patrickkolbaycertus/ProbeCardKiCAD/Probe Card Driver/Probe Card Driver.pdf

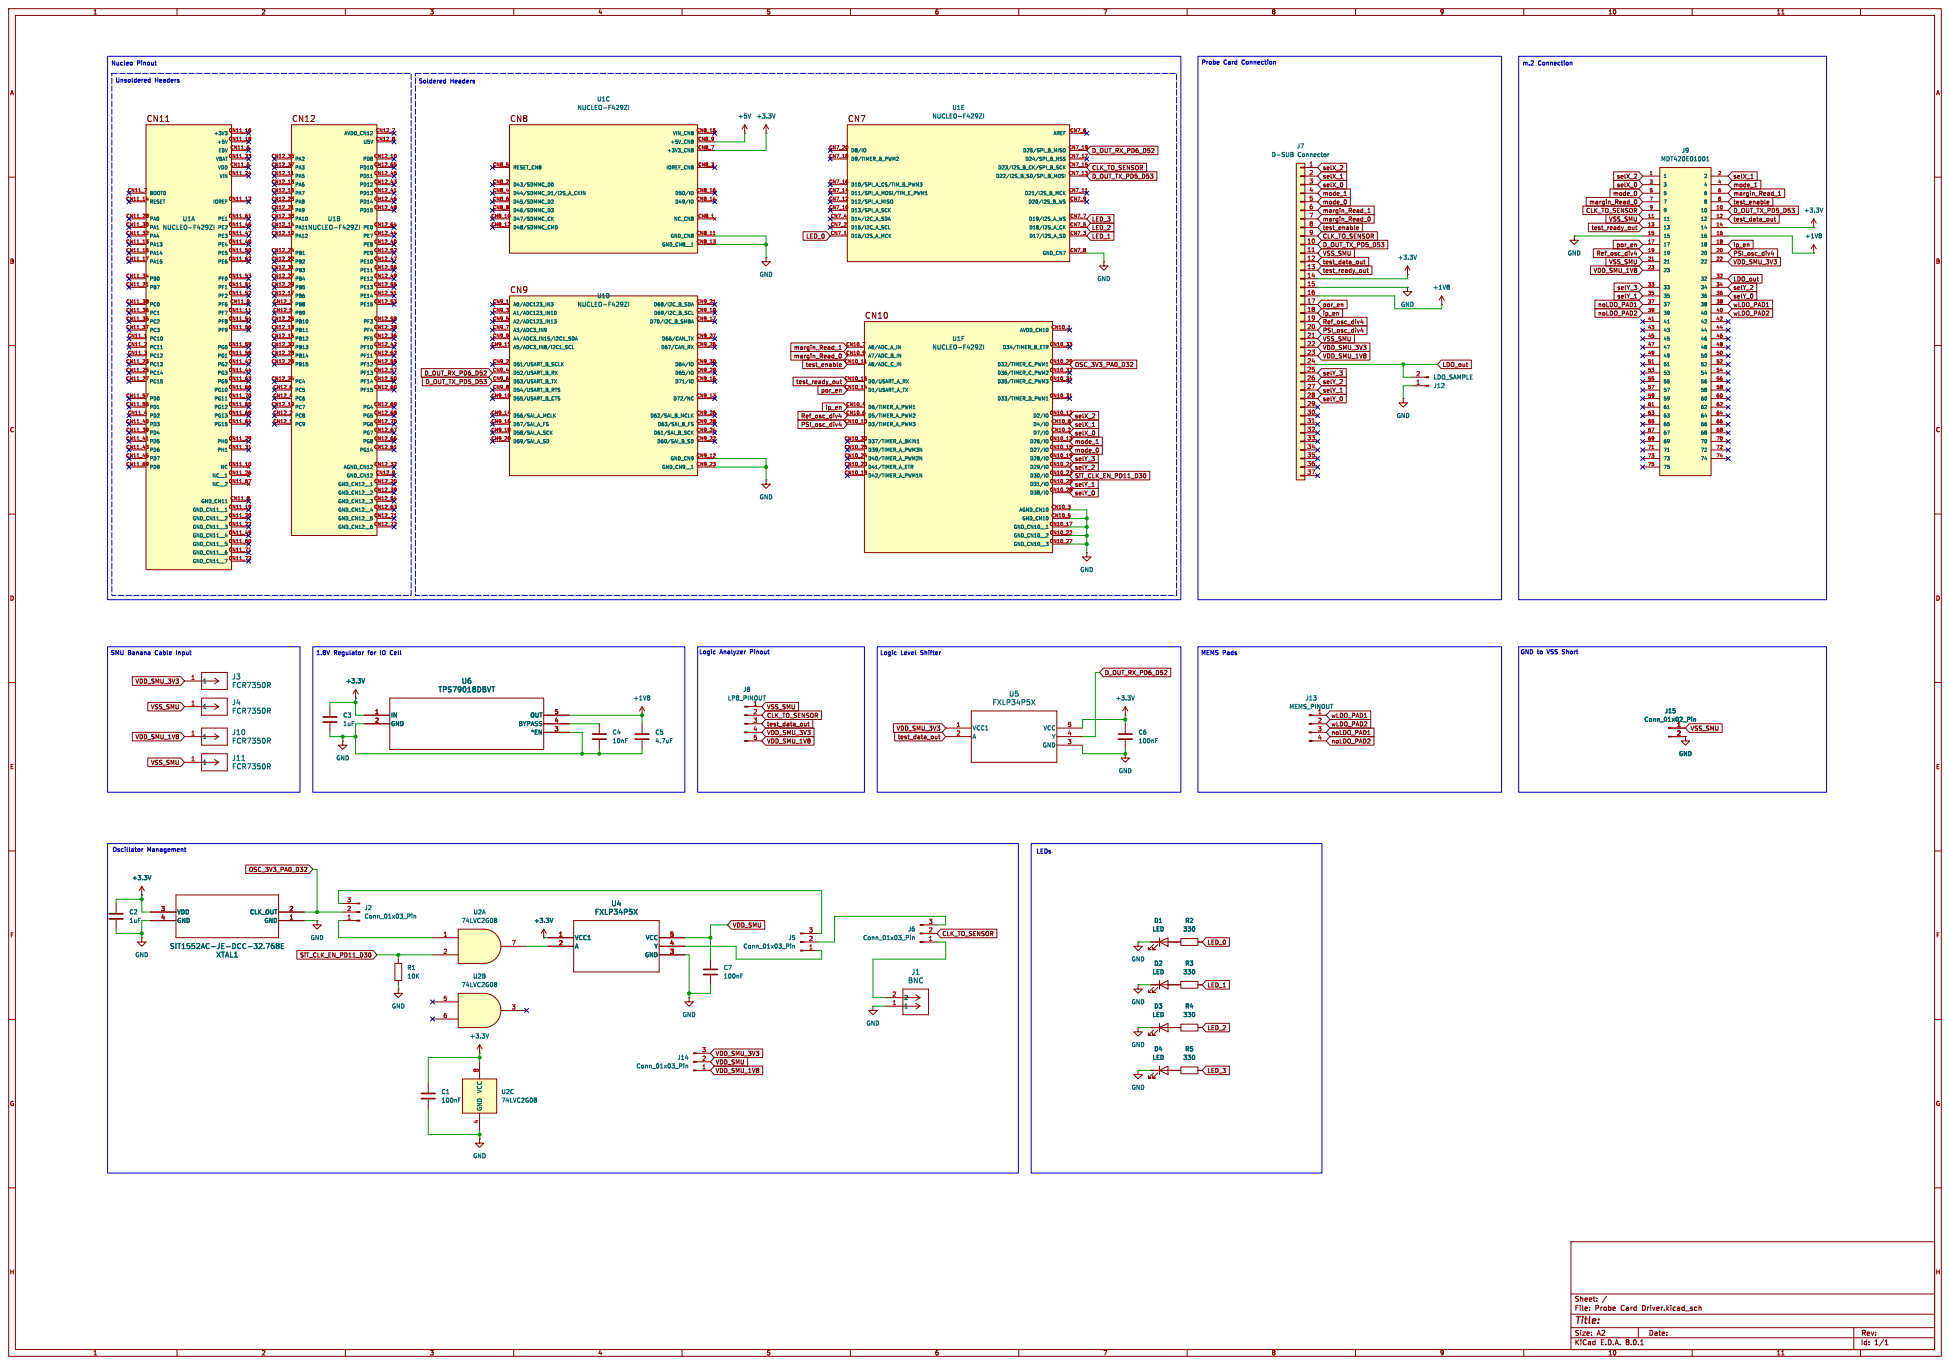
[picture p1: page 1]
