patrickkolbaycertus/ProbeCardKiCAD/Probe Card Driver/Probe Card Driver.kicad_pcb

## KiCad design Probe Card Driver/Probe Card Driver.kicad_pcb (2024-08-28)

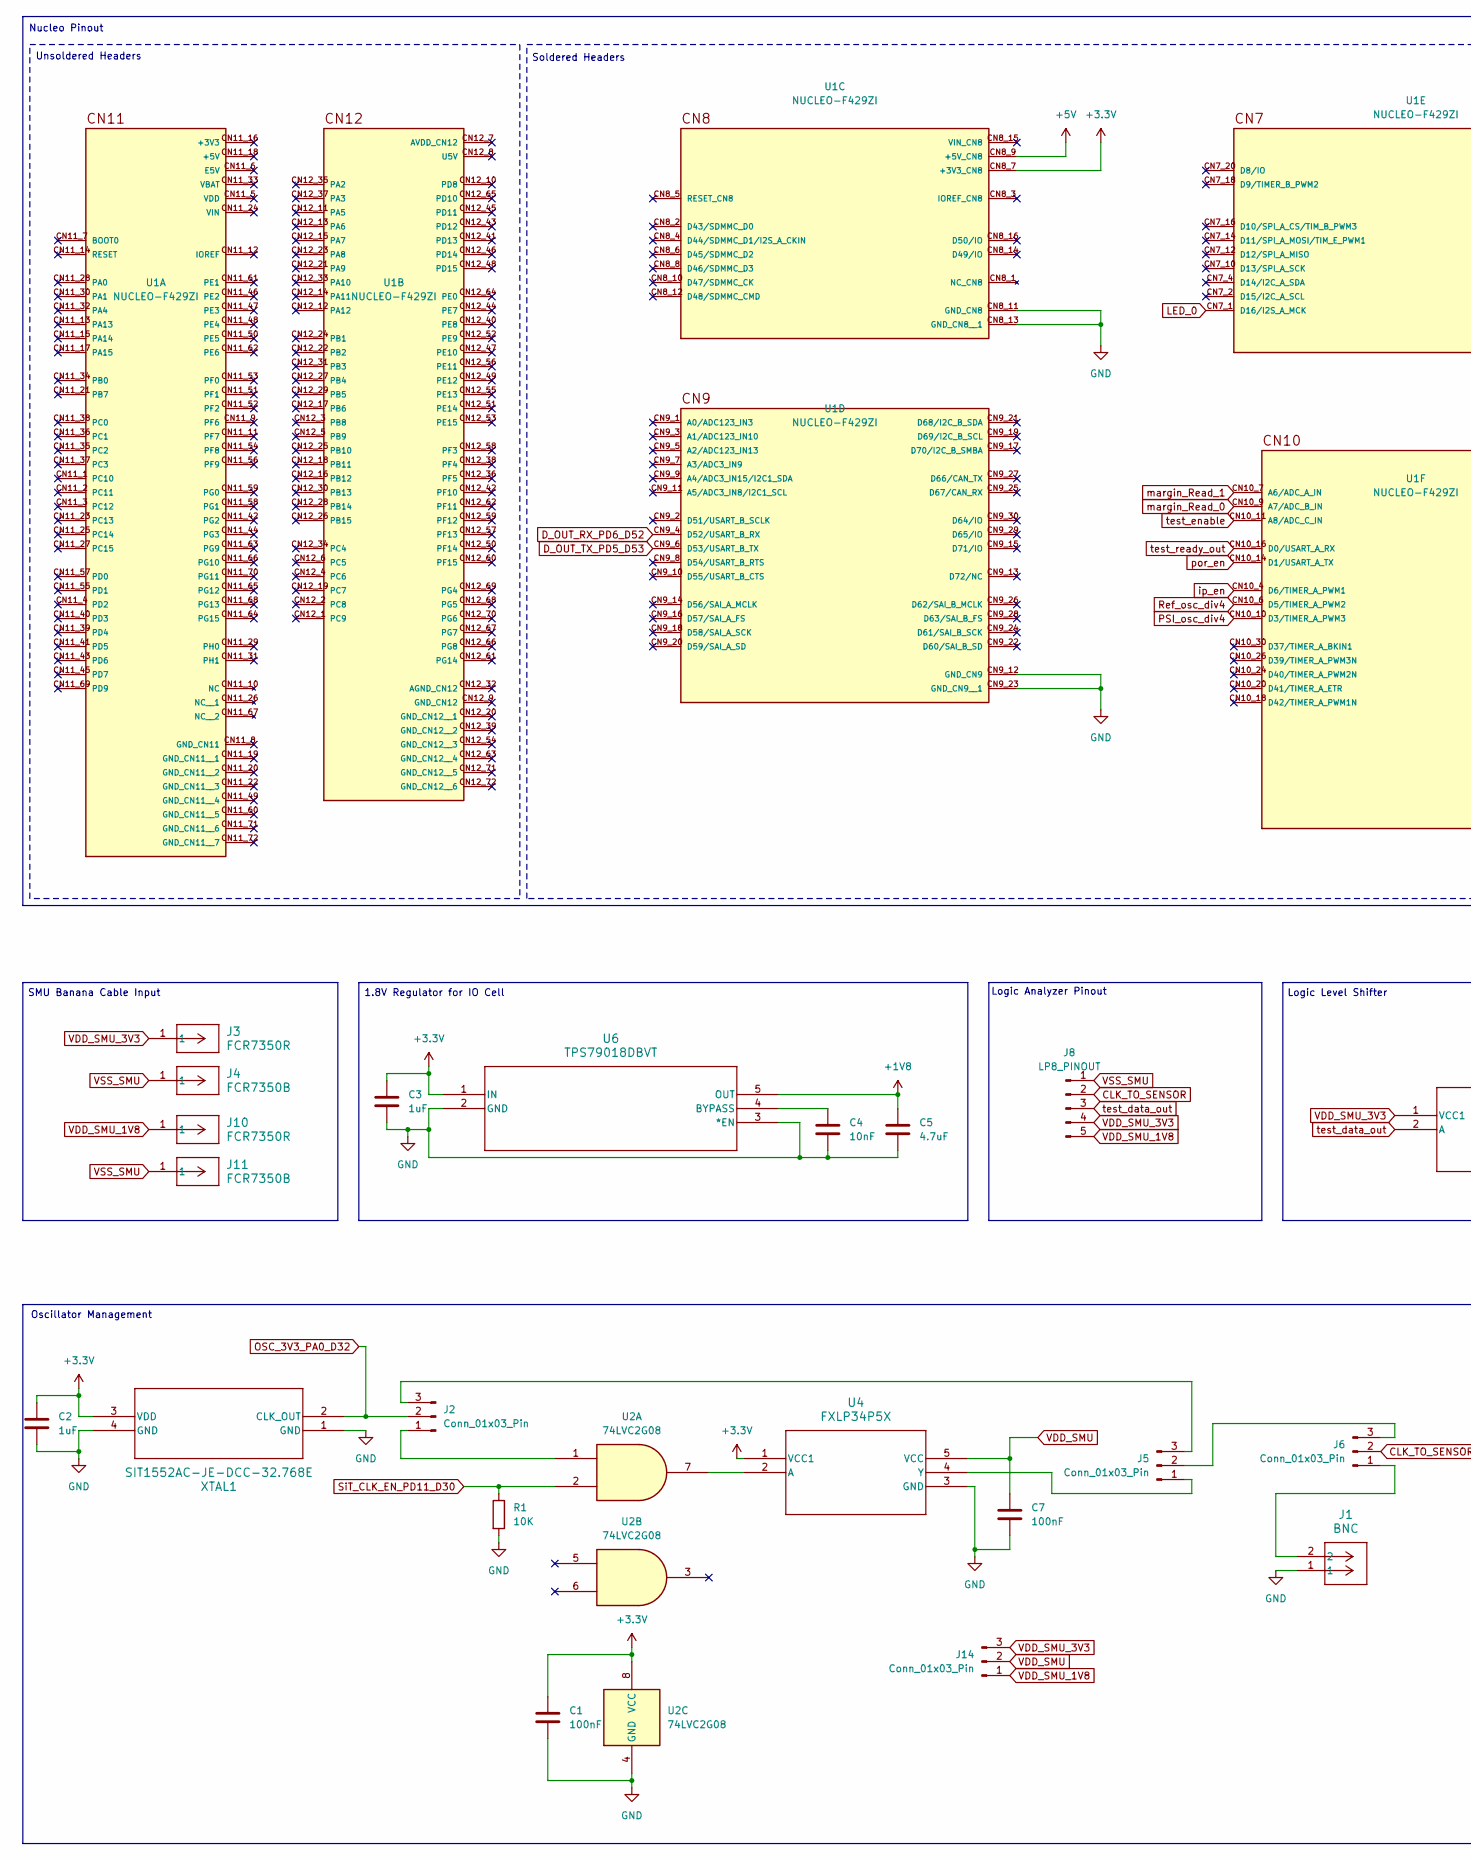
[picture p2: schematic Probe Card Driver.kicad_sch, part in row 1, column 1]

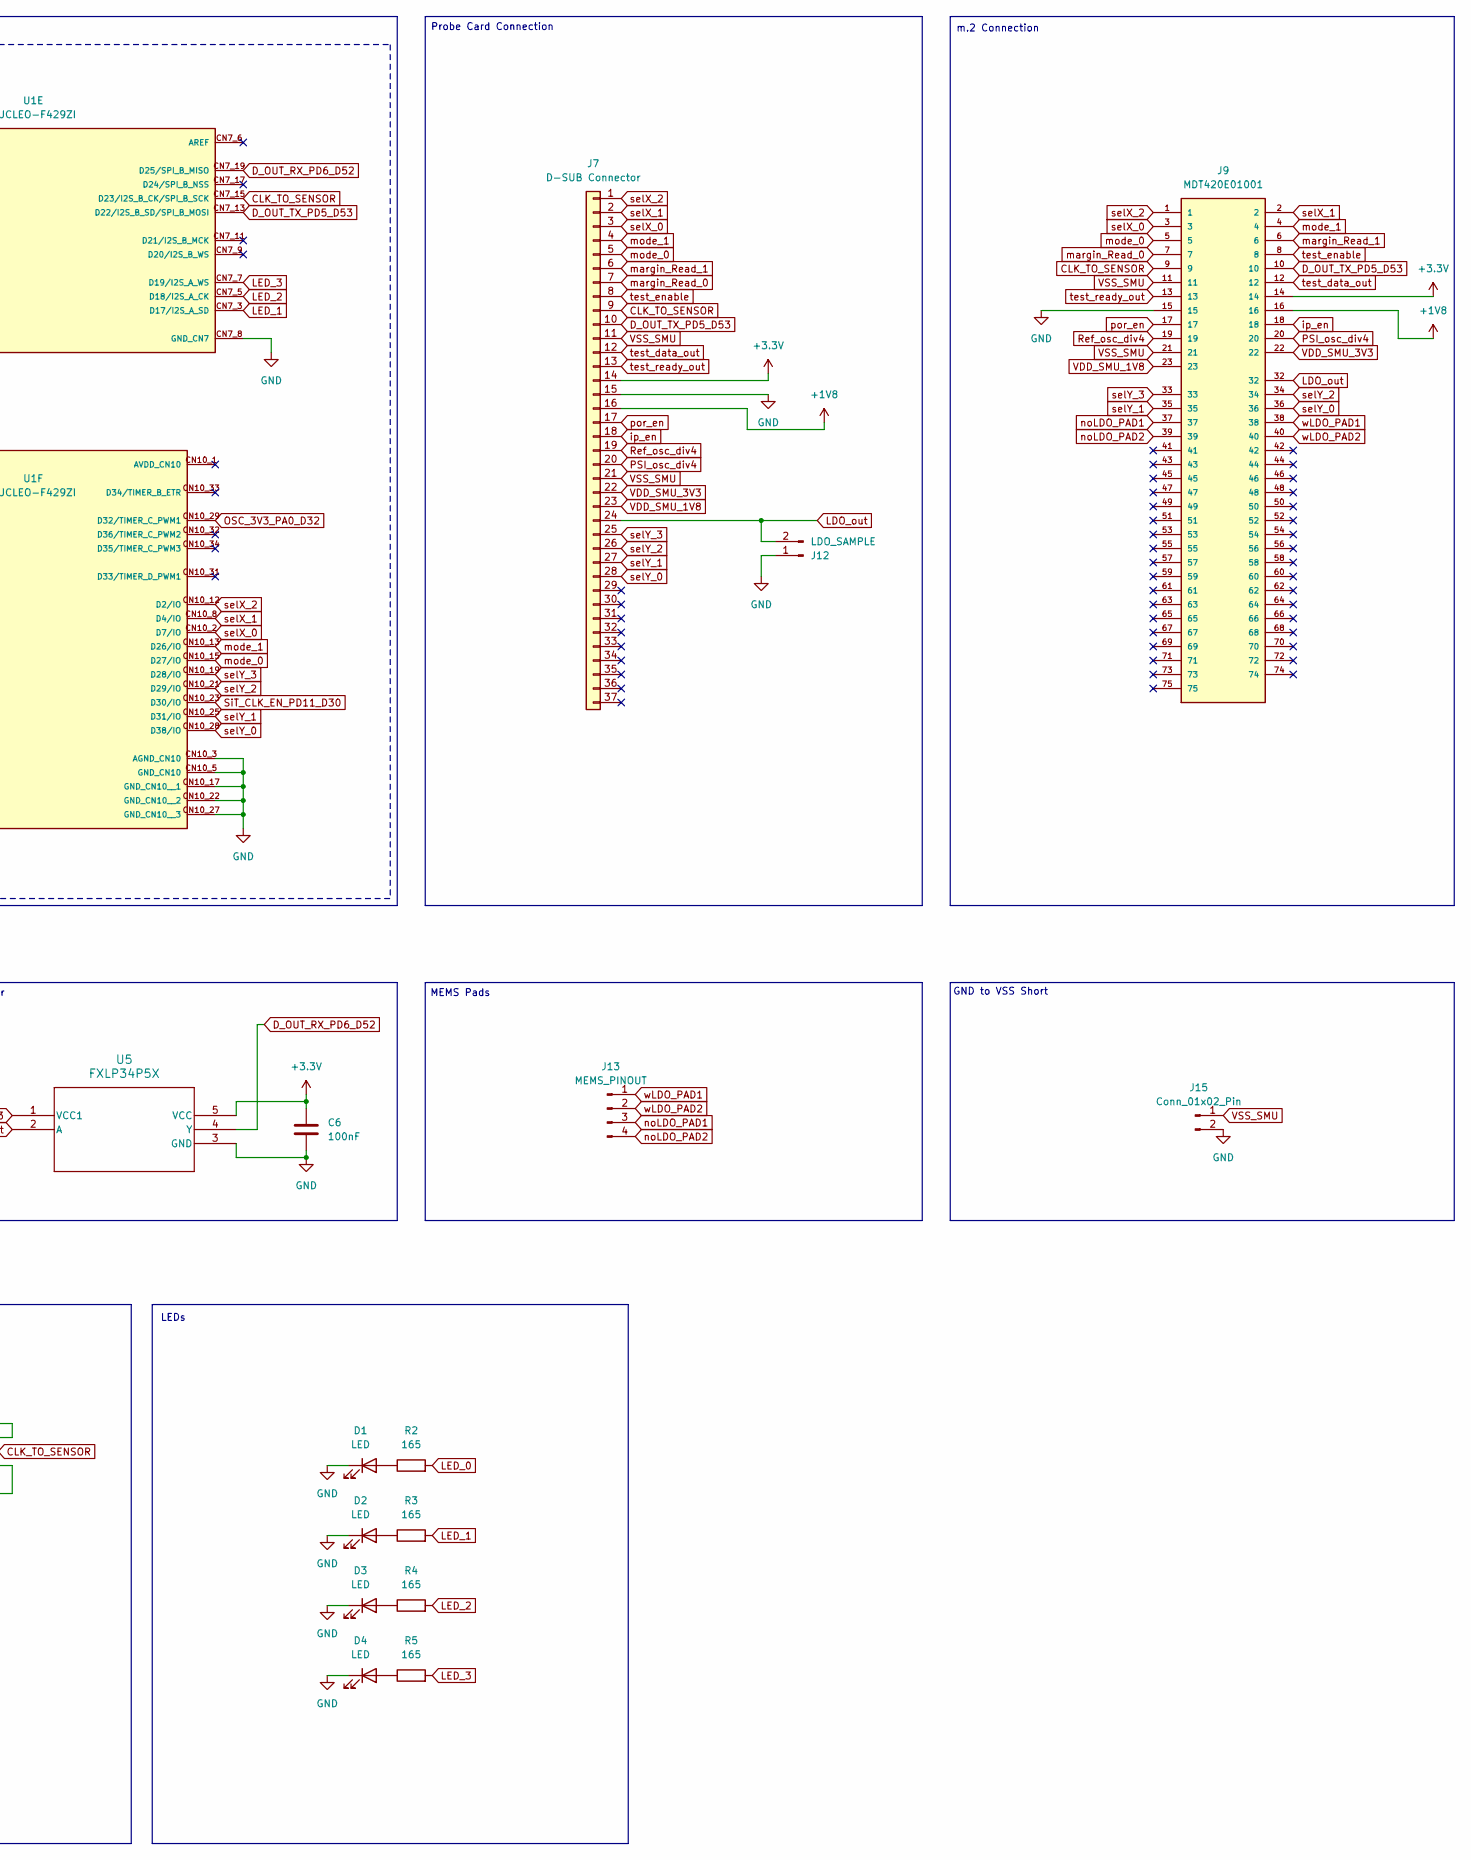
[picture p3: schematic Probe Card Driver.kicad_sch, part in row 1, column 2]

Parts:
C1, C6, C7: 100nF; C_0603_1608Metric
C2, C3: 1uF; C_0603_1608Metric
C4: 10nF; C_0603_1608Metric
C5: 4.7uF; C_0603_1608Metric
D1, D2, D3, D4: LED; LED_0603_1608Metric
J1: BNC; CONN_CONBN_LNX
J2, J5, J6, J14: Conn_01x03_Pin; PinHeader_1x03_P2.54mm_Vertical
J3, J10: FCR7350R; CONN1_FCR7350R_CLF
J4, J11: FCR7350B; CONN1_FCR7350R_CLF
J7: D-SUB Connector; D37P33E4GX00LF
J8: LP8_PINOUT; PinSocket_1x05_P2.54mm_Vertical
J9: MDT420E01001; M.2-CONNECTOR-E; PARTREV 7
J12: LDO_SAMPLE; PinSocket_1x02_P2.54mm_Vertical
J13: MEMS_PINOUT; PinSocket_1x04_P2.54mm_Vertical
J15: Conn_01x02_Pin; PinHeader_1x02_P2.54mm_Vertical
R1: 10K; R_0603_1608Metric
R2, R3, R4, R5: 165; R_0603_1608Metric
U1: NUCLEO-F429ZI; MODULE_NUCLEO-F429ZI; PARTREV 8
U2: 74LVC2G08; DCU8
U4, U5: FXLP34P5X; SC70-5_2P2X1P3_ONS
U6: TPS79018DBVT; DBV5
XTAL1: SIT1552AC-JE-DCC-32.768E; BGA4_SiT1532_SIT

Connections:
+1V8: C5.1, J7.16, J9.16, U6.5 (OUT)
+3.3V: C1.1, C2.1, C3.1, C6.1, J7.14, J9.14, U1.CN8_7 (+3V3_CN8), U2.8 (VCC), U4.1 (VCC1), U5.5 (VCC), U6.1 (IN), XTAL1.3 (VDD)
+5V: U1.CN8_9 (+5V_CN8)
CLK_TO_SENSOR: J6.2, J7.9, J8.2, J9.9, U1.CN7_15 (D23/I2S_B_CK/SPI_B_SCK)
D_OUT_RX_PD6_D52: U1.CN7_19 (D25/SPI_B_MISO), U1.CN9_4 (D52/USART_B_RX), U5.4 (Y)
D_OUT_TX_PD5_D53: J7.10, J9.10, U1.CN7_13 (D22/I2S_B_SD/SPI_B_MOSI), U1.CN9_6 (D53/USART_B_TX)
GND: C1.2, C2.2, C3.2, C4.2, C5.2, C6.2, C7.2, D1.1 (K), D2.1 (K), D3.1 (K), D4.1 (K), J1.1, J7.15, J9.15, J12.1, J15.2, R1.2, U1.CN7_8 (GND_CN7), U1.CN8_11 (GND_CN8), U1.CN8_13 (GND_CN8__1), U1.CN9_12 (GND_CN9), U1.CN9_23 (GND_CN9__1), U1.CN10_3 (AGND_CN10), U1.CN10_5 (GND_CN10), U1.CN10_17 (GND_CN10__1), U1.CN10_22 (GND_CN10__2), U1.CN10_27 (GND_CN10__3), U2.4 (GND), U4.3 (GND), U5.3 (GND), U6.2 (GND), U6.3 (*EN), XTAL1.1 (GND), XTAL1.4 (GND)
LDO_out: J7.24, J9.32, J12.2
LED_0: R2.2, U1.CN7_1 (D16/I2S_A_MCK)
LED_1: R3.2, U1.CN7_3 (D17/I2S_A_SD)
LED_2: R4.2, U1.CN7_5 (D18/I2S_A_CK)
LED_3: R5.2, U1.CN7_7 (D19/I2S_A_WS)
unnamed: D1.2 (A), R2.1
unnamed: D2.2 (A), R3.1
unnamed: D3.2 (A), R4.1
unnamed: D4.2 (A), R5.1
unnamed: J2.1, U2.1
unnamed: J2.3, J5.3
unnamed: J5.1, U4.4 (Y)
unnamed: J5.2, J6.3
unnamed: J1.2, J6.1
unnamed: U2.7, U4.2 (A)
unnamed: C4.1, U6.4 (BYPASS)
OSC_3V3_PA0_D32: J2.2, U1.CN10_29 (D32/TIMER_C_PWM1), XTAL1.2 (CLK_OUT)
PSI_osc_div4: J7.20, J9.20, U1.CN10_10 (D3/TIMER_A_PWM3)
Ref_osc_div4: J7.19, J9.19, U1.CN10_6 (D5/TIMER_A_PWM2)
SiT_CLK_EN_PD11_D30: R1.1, U1.CN10_23 (D30/IO), U2.2
VDD_SMU: C7.1, J14.2, U4.5 (VCC)
VDD_SMU_1V8: J7.23, J8.5, J9.23, J10.1, J14.1
VDD_SMU_3V3: J3.1, J7.22, J8.4, J9.22, J14.3, U5.1 (VCC1)
VSS_SMU: J4.1, J7.11, J7.21, J8.1, J9.11, J9.21, J11.1, J15.1
ip_en: J7.18, J9.18, U1.CN10_4 (D6/TIMER_A_PWM1)
margin_Read_0: J7.7, J9.7, U1.CN10_9 (A7/ADC_B_IN)
margin_Read_1: J7.6, J9.6, U1.CN10_7 (A6/ADC_A_IN)
mode_0: J7.5, J9.5, U1.CN10_15 (D27/IO)
mode_1: J7.4, J9.4, U1.CN10_13 (D26/IO)
noLDO_PAD1: J9.37, J13.3
noLDO_PAD2: J9.39, J13.4
por_en: J7.17, J9.17, U1.CN10_14 (D1/USART_A_TX)
selX_0: J7.3, J9.3, U1.CN10_2 (D7/IO)
selX_1: J7.2, J9.2, U1.CN10_8 (D4/IO)
selX_2: J7.1, J9.1, U1.CN10_12 (D2/IO)
selY_0: J7.28, J9.36, U1.CN10_28 (D38/IO)
selY_1: J7.27, J9.35, U1.CN10_25 (D31/IO)
selY_2: J7.26, J9.34, U1.CN10_21 (D29/IO)
selY_3: J7.25, J9.33, U1.CN10_19 (D28/IO)
test_data_out: J7.12, J8.3, J9.12, U5.2 (A)
test_enable: J7.8, J9.8, U1.CN10_11 (A8/ADC_C_IN)
test_ready_out: J7.13, J9.13, U1.CN10_16 (D0/USART_A_RX)
wLDO_PAD1: J9.38, J13.1
wLDO_PAD2: J9.40, J13.2

Notes on the sheet:
Unsoldered Headers
Soldered Headers
1.8V Regulator for IO Cell
LEDs
MEMS Pads
Oscillator Management
Nucleo Pinout
Logic Analyzer Pinout
m.2 Connection
Logic Level Shifter
Probe Card Connection
SMU Banana Cable Input
GND to VSS Short

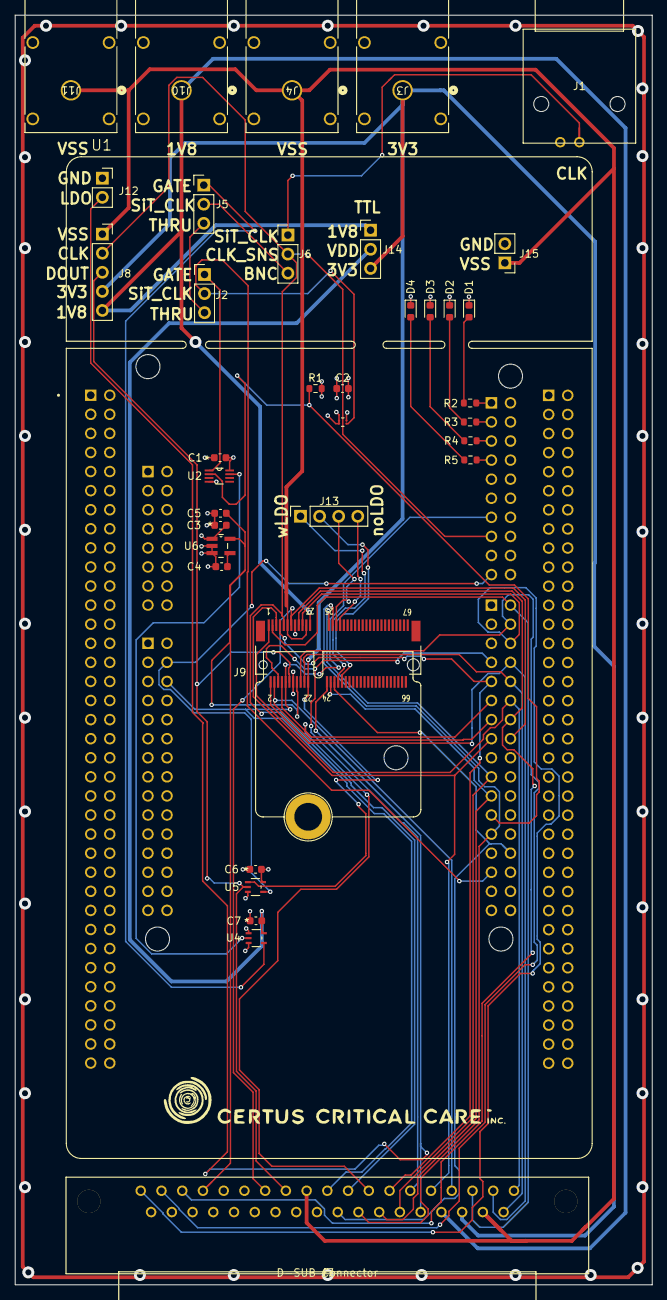
[picture p4: board Probe Card Driver.kicad_pcb from above]

Board: 4 copper layers, 84.8 x 169.0 mm, 37 parts (0 on the bottom side), 50 nets.
