patrickkolbaycertus/ProbeCardKiCAD/(commit log)

2024-08-28 Add files via upload
    Initial commit
    [Probe Card Driver.kicad_pcb, Probe Card Driver.kicad_sch]
2024-08-28 Added BOM and Minor Updates
    Added a BOM and included minor updates to layout and schematic.
    [Probe Card Driver BOM.csv, Probe Card Driver.kicad_pcb, Probe Card Driver.kicad_sch]
